aweshome/weather_station/README.md

# Weather station

## Internal unit (terminal)

### Heart:
	ATmega1284
	
### Peripherals:
	EG9018C - 640x480 8.4" mono lcd screen
	DS3231 - rtc
	BMP180 - pressure sensor
	nRF24L01 - wireless transceiver
	AM2302 - temperature and humidity sensor

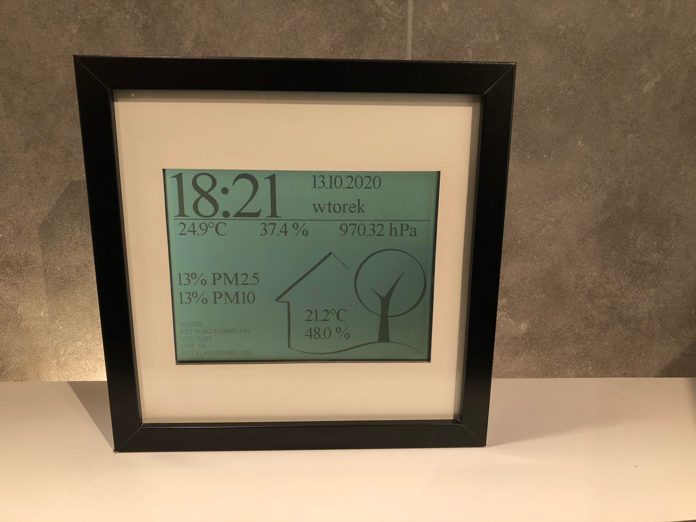
[picture p1: internal_terminal/images/internal_terminal_real_1.jpg]
internal real

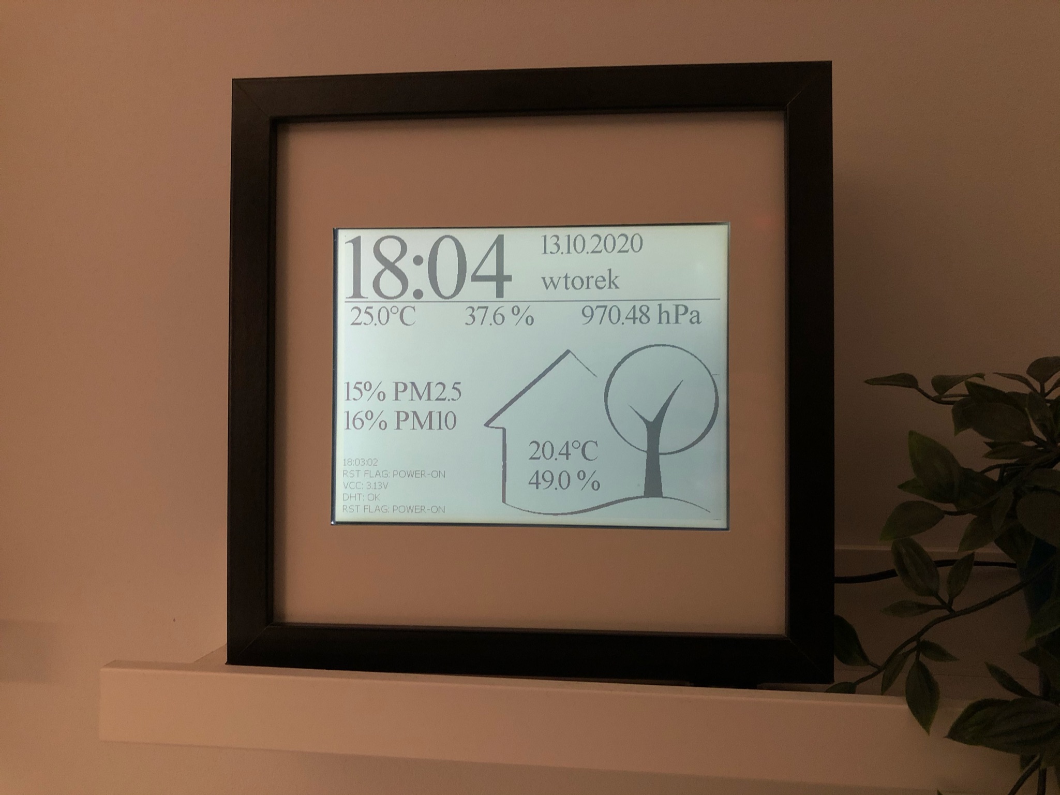
[picture p2: internal_terminal/images/internal_terminal_real_2.jpg]
internal real

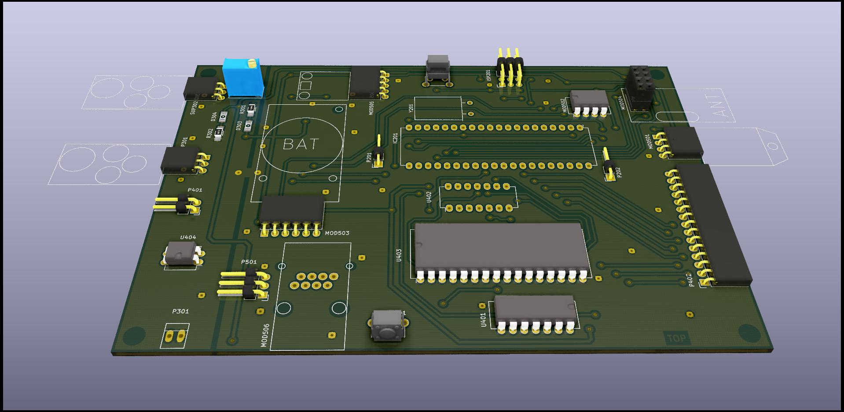
[picture p3: internal_terminal/images/internal_terminal_pcb_top.jpg]
internal pcb top

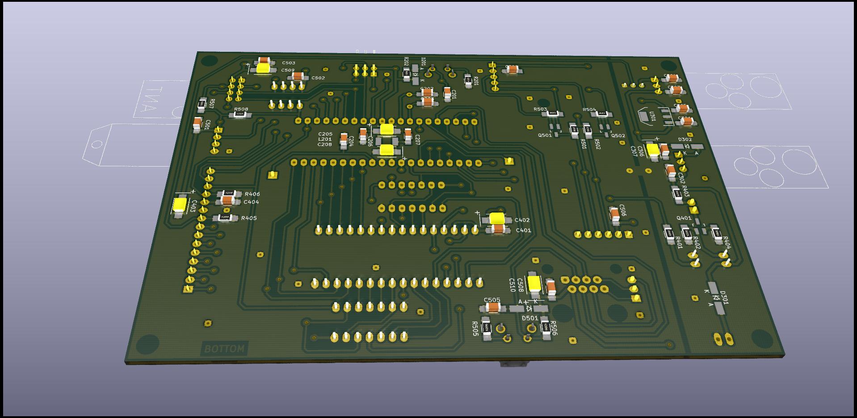
[picture p4: internal_terminal/images/internal_terminal_pcb_bottom.jpg]
internal pcb bottom


## External unit (sensor)

### Heart:
	ATxmega128A3U - uC
	
### Peripherals:
	PMSA003 - dust sensor
	nRF24L01
	AM2302	

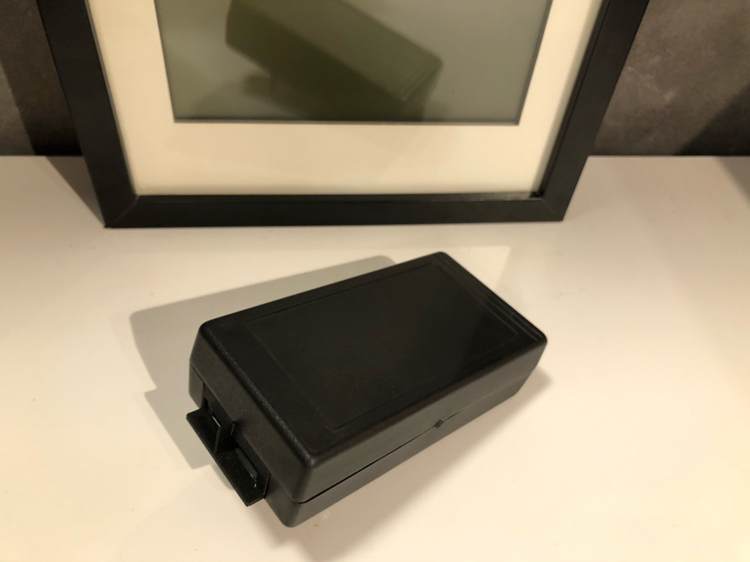
[picture p5: external_sensor/images/external_sensor_real_1.jpg]
external real

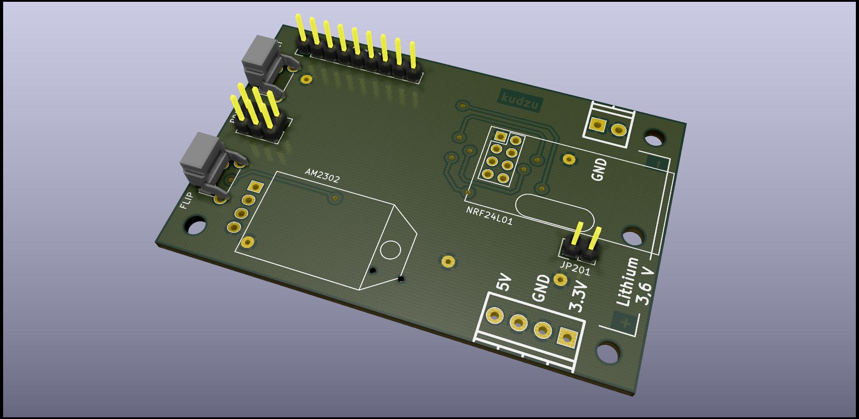
[picture p6: external_sensor/images/external_sensor_pcb_top.jpg]
external pcb top

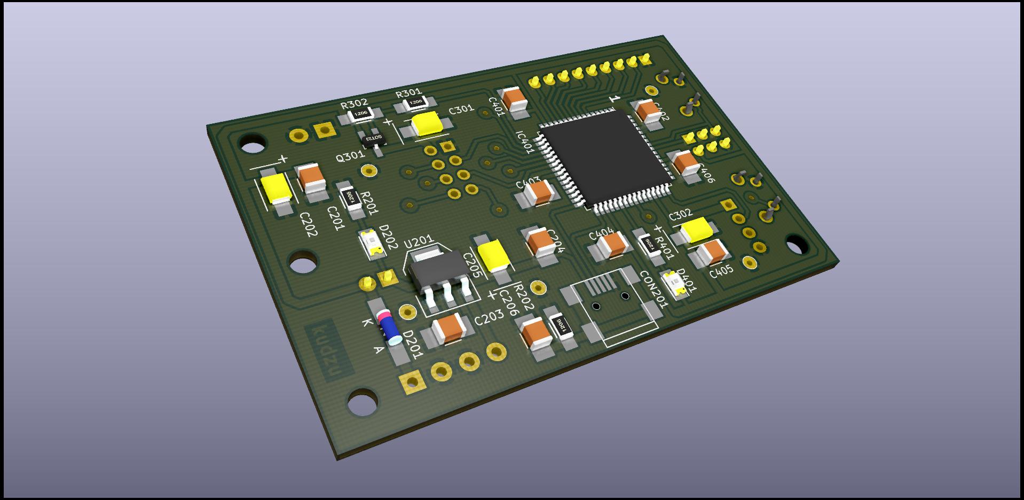
[picture p7: external_sensor/images/external_sensor_pcb_bottom.jpg]
external pcb bottom
