aweshome/weather_station/internal_terminal/hardware/solar_system_terminal_board.kicad_pcb

## KiCad design internal_terminal/hardware/solar_system_terminal_board.kicad_pcb (2020-10-13)

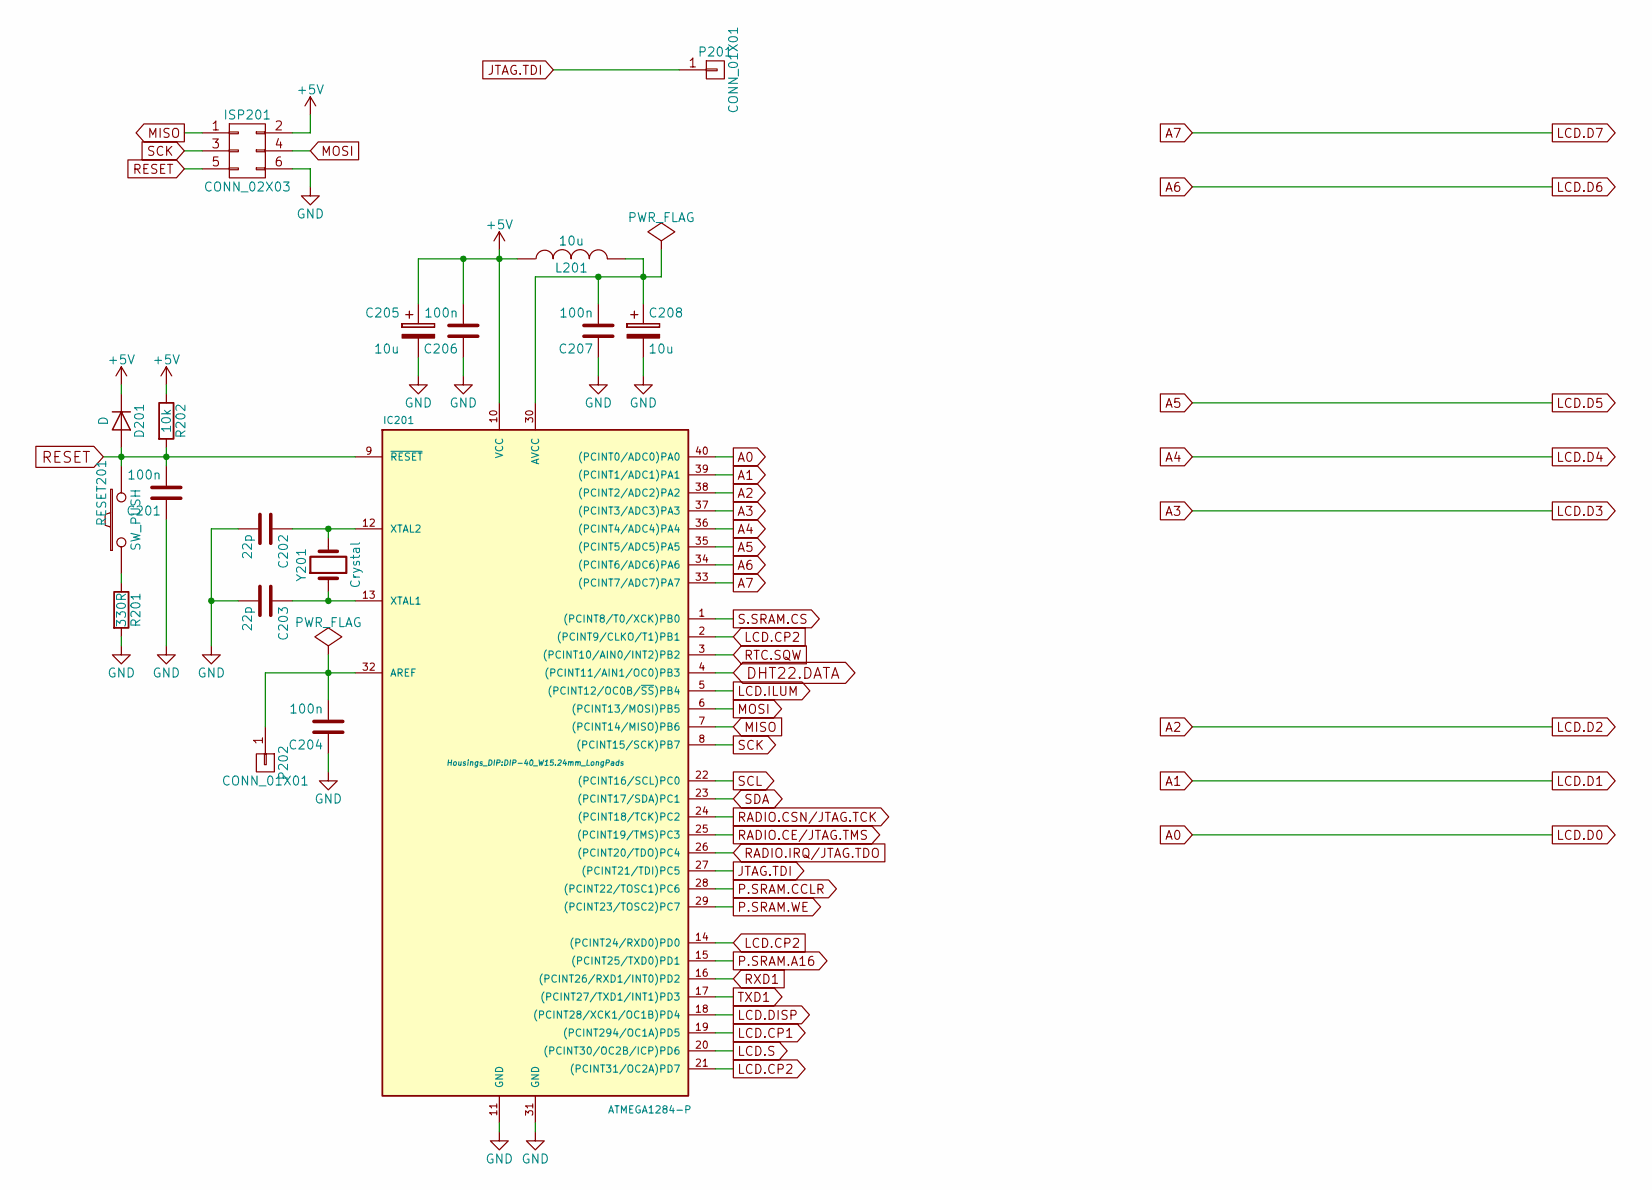
[picture p17: schematic main_unit.sch]

Parts:
C201, C204, C206, C207: 100n; C_1206_HandSoldering
C202, C203: 22p; C_1206_HandSoldering
C205, C208: 10u; TantalC_SizeB_EIA-3528_HandSoldering
D201: D; Diode-MiniMELF_Handsoldering
IC201: ATMEGA1284-P; DIP-40_W15.24mm_LongPads
ISP201: CONN_02X03; Pin_Header_Angled_2x03
L201: 10u; Neosid_Inductor_SM-NE45_SMD1812
P201, P202: CONN_01X01; Pin_Header_Straight_1x01
R201: 330R; R_1206_HandSoldering
R202: 10k; R_1206_HandSoldering
RESET201: SW_PUSH; SW_Tactile_SPST_Angled
Y201: Crystal; Crystal_HC49-U_Horizontal_Typ1

Connections:
+5V: C205.1, C206.2, D201.1 (K), IC201.10 (VCC), ISP201.2, L201.1, R202.1; also elsewhere on the board
A0: IC201.40 ((PCINT0/ADC0)PA0); also elsewhere on the board
A1: IC201.39 ((PCINT1/ADC1)PA1); also elsewhere on the board
A2: IC201.38 ((PCINT2/ADC2)PA2); also elsewhere on the board
A3: IC201.37 ((PCINT3/ADC3)PA3); also elsewhere on the board
A4: IC201.36 ((PCINT4/ADC4)PA4); also elsewhere on the board
A5: IC201.35 ((PCINT5/ADC5)PA5); also elsewhere on the board
A6: IC201.34 ((PCINT6/ADC6)PA6); also elsewhere on the board
A7: IC201.33 ((PCINT7/ADC7)PA7); also elsewhere on the board
DHT22.DATA: IC201.4 ((PCINT11/AIN1/OC0)PB3); also elsewhere on the board
GND: C201.1, C202.2, C203.2, C204.1, C205.2, C206.1, C207.1, C208.2, IC201.11 (GND), IC201.31 (GND), ISP201.6, R201.2; also elsewhere on the board
JTAG.TDI: IC201.27 ((PCINT21/TDI)PC5), P201.1
LCD.CP1: IC201.19 ((PCINT294/OC1A)PD5); also elsewhere on the board
LCD.CP2: IC201.2 ((PCINT9/CLKO/T1)PB1), IC201.14 ((PCINT24/RXD0)PD0), IC201.21 ((PCINT31/OC2A)PD7); also elsewhere on the board
LCD.DISP: IC201.18 ((PCINT28/XCK1/OC1B)PD4); also elsewhere on the board
LCD.ILUM: IC201.5 ((PCINT12/OC0B/~SS~)PB4); also elsewhere on the board
LCD.S: IC201.20 ((PCINT30/OC2B/ICP)PD6); also elsewhere on the board
MISO: IC201.7 ((PCINT14/MISO)PB6), ISP201.1; also elsewhere on the board
MOSI: IC201.6 ((PCINT13/MOSI)PB5), ISP201.4; also elsewhere on the board
unnamed: C202.1, IC201.12 (XTAL2), Y201.2
unnamed: C203.1, IC201.13 (XTAL1), Y201.1
unnamed: C204.2, IC201.32 (AREF), P202.1
unnamed: C207.2, C208.1, IC201.30 (AVCC), L201.2
unnamed: R201.1, RESET201.1
P.SRAM.A16: IC201.15 ((PCINT25/TXD0)PD1); also elsewhere on the board
P.SRAM.CCLR: IC201.28 ((PCINT22/TOSC1)PC6); also elsewhere on the board
P.SRAM.WE: IC201.29 ((PCINT23/TOSC2)PC7); also elsewhere on the board
RADIO.CE/JTAG.TMS: IC201.25 ((PCINT19/TMS)PC3); also elsewhere on the board
RADIO.CSN/JTAG.TCK: IC201.24 ((PCINT18/TCK)PC2); also elsewhere on the board
RADIO.IRQ/JTAG.TDO: IC201.26 ((PCINT20/TDO)PC4); also elsewhere on the board
RESET: C201.2, D201.2 (A), IC201.9 (~RESET), ISP201.5, R202.2, RESET201.2
RTC.SQW: IC201.3 ((PCINT10/AIN0/INT2)PB2); also elsewhere on the board
RXD1: IC201.16 ((PCINT26/RXD1/INT0)PD2); also elsewhere on the board
S.SRAM.CS: IC201.1 ((PCINT8/T0/XCK)PB0); also elsewhere on the board
SCK: IC201.8 ((PCINT15/SCK)PB7), ISP201.3; also elsewhere on the board
SCL: IC201.22 ((PCINT16/SCL)PC0); also elsewhere on the board
SDA: IC201.23 ((PCINT17/SDA)PC1); also elsewhere on the board
TXD1: IC201.17 ((PCINT27/TXD1/INT1)PD3); also elsewhere on the board

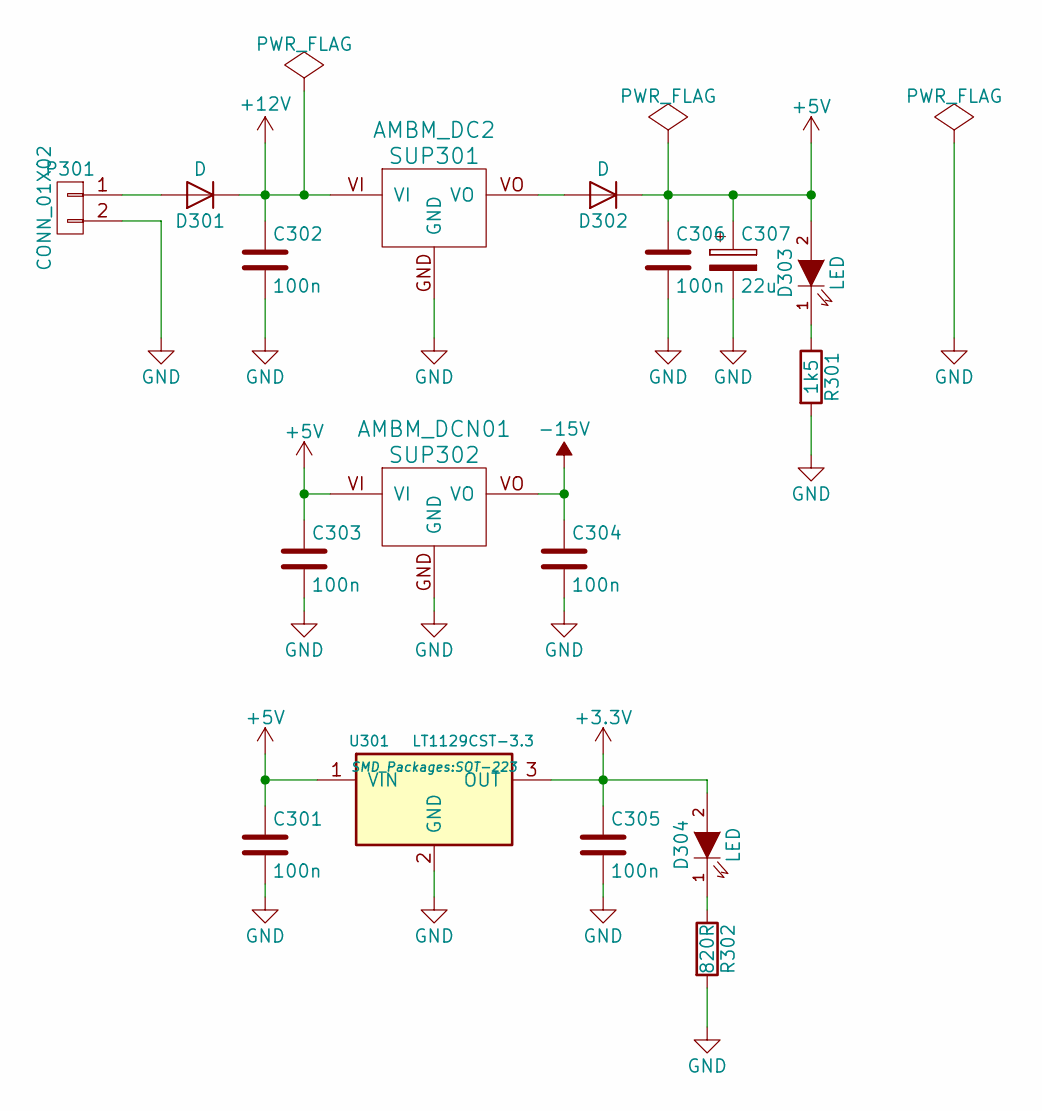
[picture p18: schematic supply.sch]

Parts:
C301, C302, C303, C304, C305, C306: 100n; C_1206_HandSoldering
C307: 22u; TantalC_SizeB_EIA-3528_HandSoldering
D301, D302: D; Diode-MiniMELF_Handsoldering
D303, D304: LED; LED-1206
P301: CONN_01X02; AK300-2
R301: 1k5; R_1206_HandSoldering
R302: 820R; R_1206_HandSoldering
SUP301: AMBM_DC2; DC2_Socket_H
SUP302: AMBM_DCN01; DC2_Socket_H
U301: LT1129CST-3.3; SOT-223

Connections:
+3V3: C305.1, D304.2 (A), U301.3 (OUT); also elsewhere on the board
+5V: C301.1, C303.1, C306.1, C307.1, D302.1 (K), D303.2 (A), SUP302.VI, U301.1 (VIN); also elsewhere on the board
+12V: C302.1, D301.1 (K), SUP301.VI; also elsewhere on the board
-15V: C304.1, SUP302.VO; also elsewhere on the board
GND: C301.2, C302.2, C303.2, C304.2, C305.2, C306.2, C307.2, P301.2, R301.2, R302.2, SUP301.GND, SUP302.GND, U301.2 (GND); also elsewhere on the board
unnamed: D301.2 (A), P301.1
unnamed: D302.2 (A), SUP301.VO
unnamed: D303.1 (K), R301.1
unnamed: D304.1 (K), R302.1

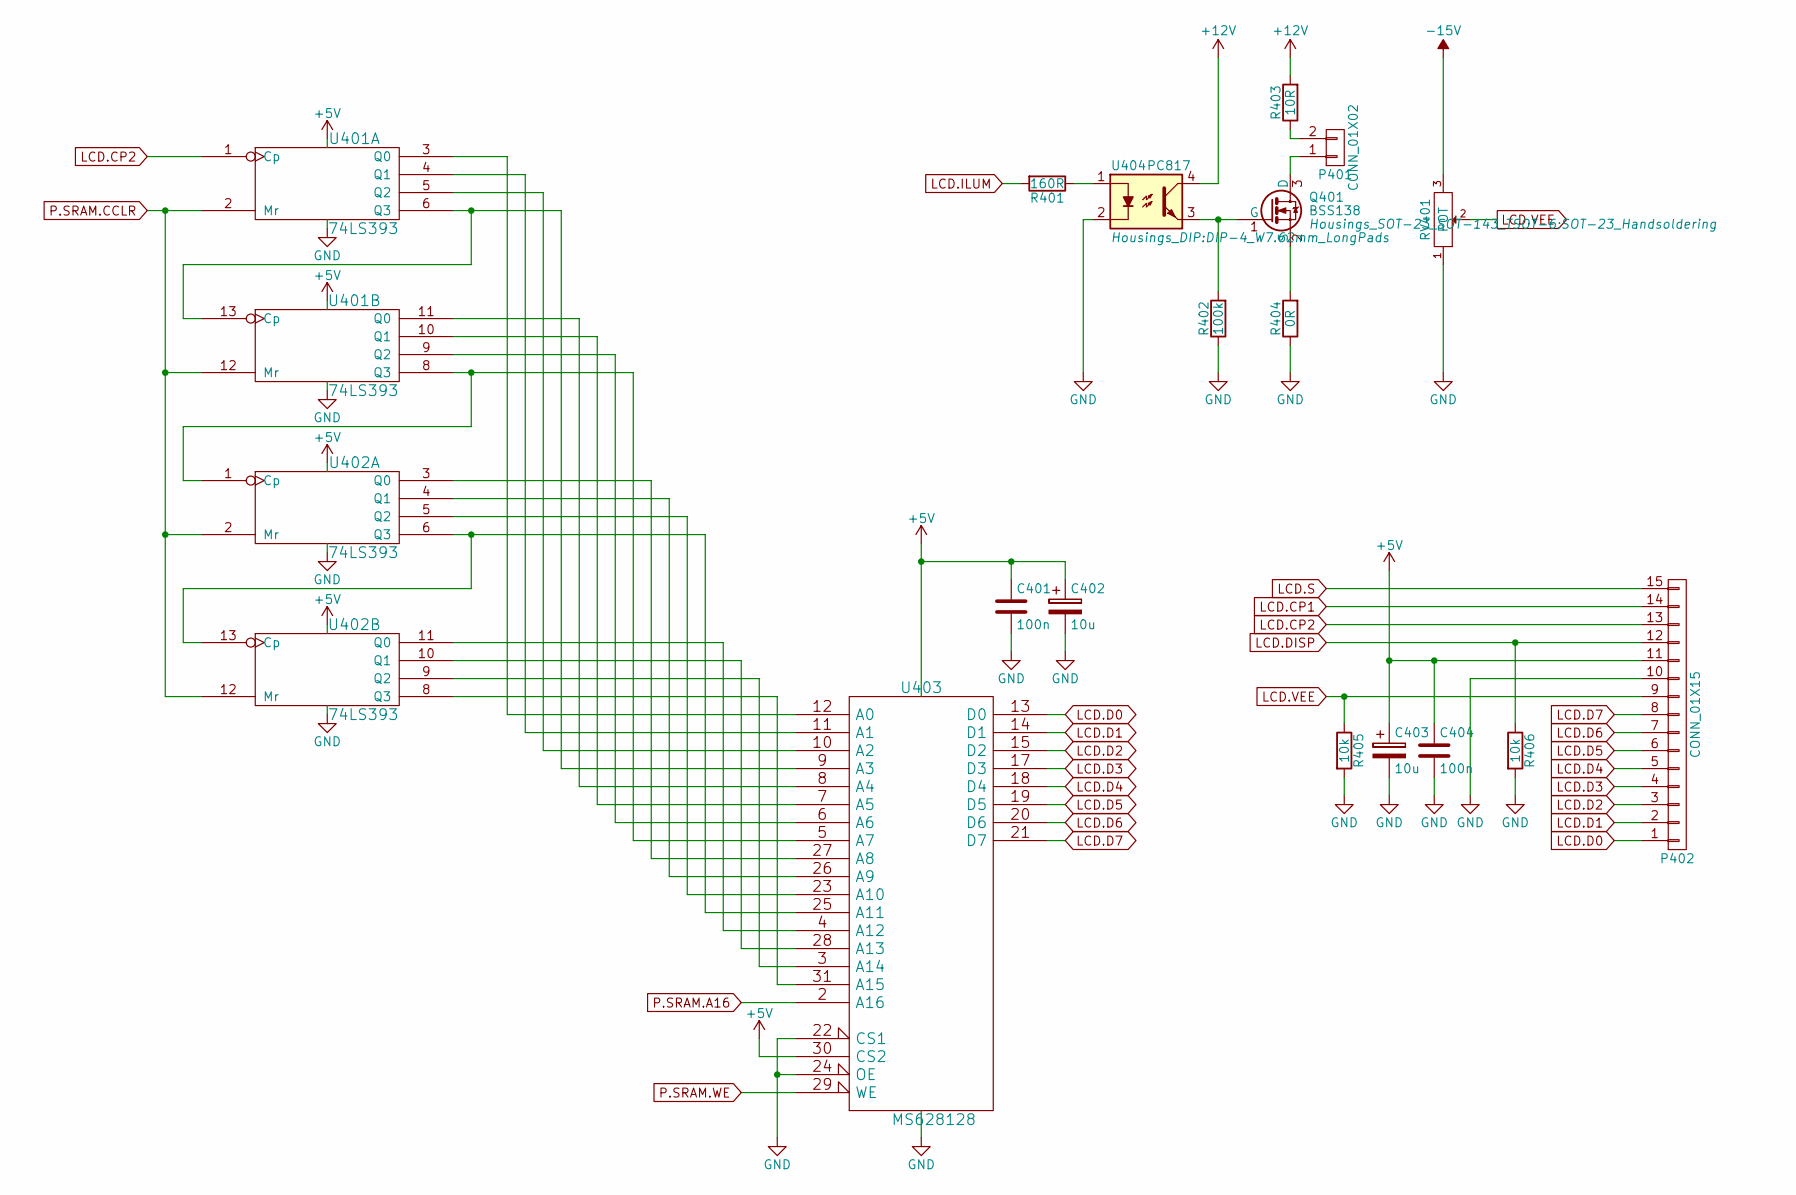
[picture p19: schematic lcd.sch]

Parts:
C401, C404: 100n; C_1206_HandSoldering
C402, C403: 10u; TantalC_SizeB_EIA-3528_HandSoldering
P401: CONN_01X02; Pin_Header_Angled_1x02
P402: CONN_01X15; Socket_Strip_Straight_1x15
Q401: BSS138; SOT-23_Handsoldering
R401: 160R; R_1206_HandSoldering
R402: 100k; R_1206_HandSoldering
R403: 10R; R_1206_HandSoldering
R404: 0R; R_1206_HandSoldering
R405, R406: 10k; R_1206_HandSoldering
RV401: POT; Potentiometer_Bourns_3296W_3-8Zoll_Inline_ScrewUp
U401, U402: 74LS393; DIP-14_W7.62mm_LongPads
U403: MS628128; DIP-32_W15.24mm_LongPads
U404: PC817; DIP-4_W7.62mm_LongPads

Connections:
+5V: C401.1, C402.1, C403.1, C404.1, P402.11, U401.14 (VCC), U402.14 (VCC), U403.30 (CS2), U403.32 (VCC); also elsewhere on the board
+12V: R403.2, U404.4; also elsewhere on the board
-15V: RV401.3; also elsewhere on the board
A0: P402.1, U403.13 (D0); also elsewhere on the board
A1: P402.2, U403.14 (D1); also elsewhere on the board
A2: P402.3, U403.15 (D2); also elsewhere on the board
A3: P402.4, U403.17 (D3); also elsewhere on the board
A4: P402.5, U403.18 (D4); also elsewhere on the board
A5: P402.6, U403.19 (D5); also elsewhere on the board
A6: P402.7, U403.20 (D6); also elsewhere on the board
A7: P402.8, U403.21 (D7); also elsewhere on the board
GND: C401.2, C402.2, C403.2, C404.2, P402.10, R402.1, R404.1, R405.2, R406.2, RV401.1, U401.7 (GND), U402.7 (GND), U403.16 (GND), U403.22 (CS1), U403.24 (OE), U404.2; also elsewhere on the board
LCD.CP1: P402.14; also elsewhere on the board
LCD.CP2: P402.13, U401.1 (Cp); also elsewhere on the board
LCD.DISP: P402.12, R406.1; also elsewhere on the board
LCD.ILUM: R401.2; also elsewhere on the board
LCD.S: P402.15; also elsewhere on the board
LCD.VEE: P402.9, R405.1, RV401.2
unnamed: P401.1, Q401.3 (D)
unnamed: P401.2, R403.1
unnamed: Q401.1 (G), R402.2, U404.3
unnamed: Q401.2 (S), R404.2
unnamed: R401.1, U404.1
unnamed: U401.3 (Q0), U403.12 (A0)
unnamed: U401.4 (Q1), U403.11 (A1)
unnamed: U401.5 (Q2), U403.10 (A2)
unnamed: U401.8 (Q3), U402.1 (Cp), U403.5 (A7)
unnamed: U401.9 (Q2), U403.6 (A6)
unnamed: U401.10 (Q1), U403.7 (A5)
unnamed: U401.11 (Q0), U403.8 (A4)
unnamed: U401.6 (Q3), U401.13 (Cp), U403.9 (A3)
unnamed: U402.3 (Q0), U403.27 (A8)
unnamed: U402.4 (Q1), U403.26 (A9)
unnamed: U402.5 (Q2), U403.23 (A10)
unnamed: U402.8 (Q3), U403.31 (A15)
unnamed: U402.9 (Q2), U403.3 (A14)
unnamed: U402.10 (Q1), U403.28 (A13)
unnamed: U402.11 (Q0), U403.4 (A12)
unnamed: U402.6 (Q3), U402.13 (Cp), U403.25 (A11)
P.SRAM.A16: U403.2 (A16); also elsewhere on the board
P.SRAM.CCLR: U401.2 (Mr), U401.12 (Mr), U402.2 (Mr), U402.12 (Mr); also elsewhere on the board
P.SRAM.WE: U403.29 (WE); also elsewhere on the board

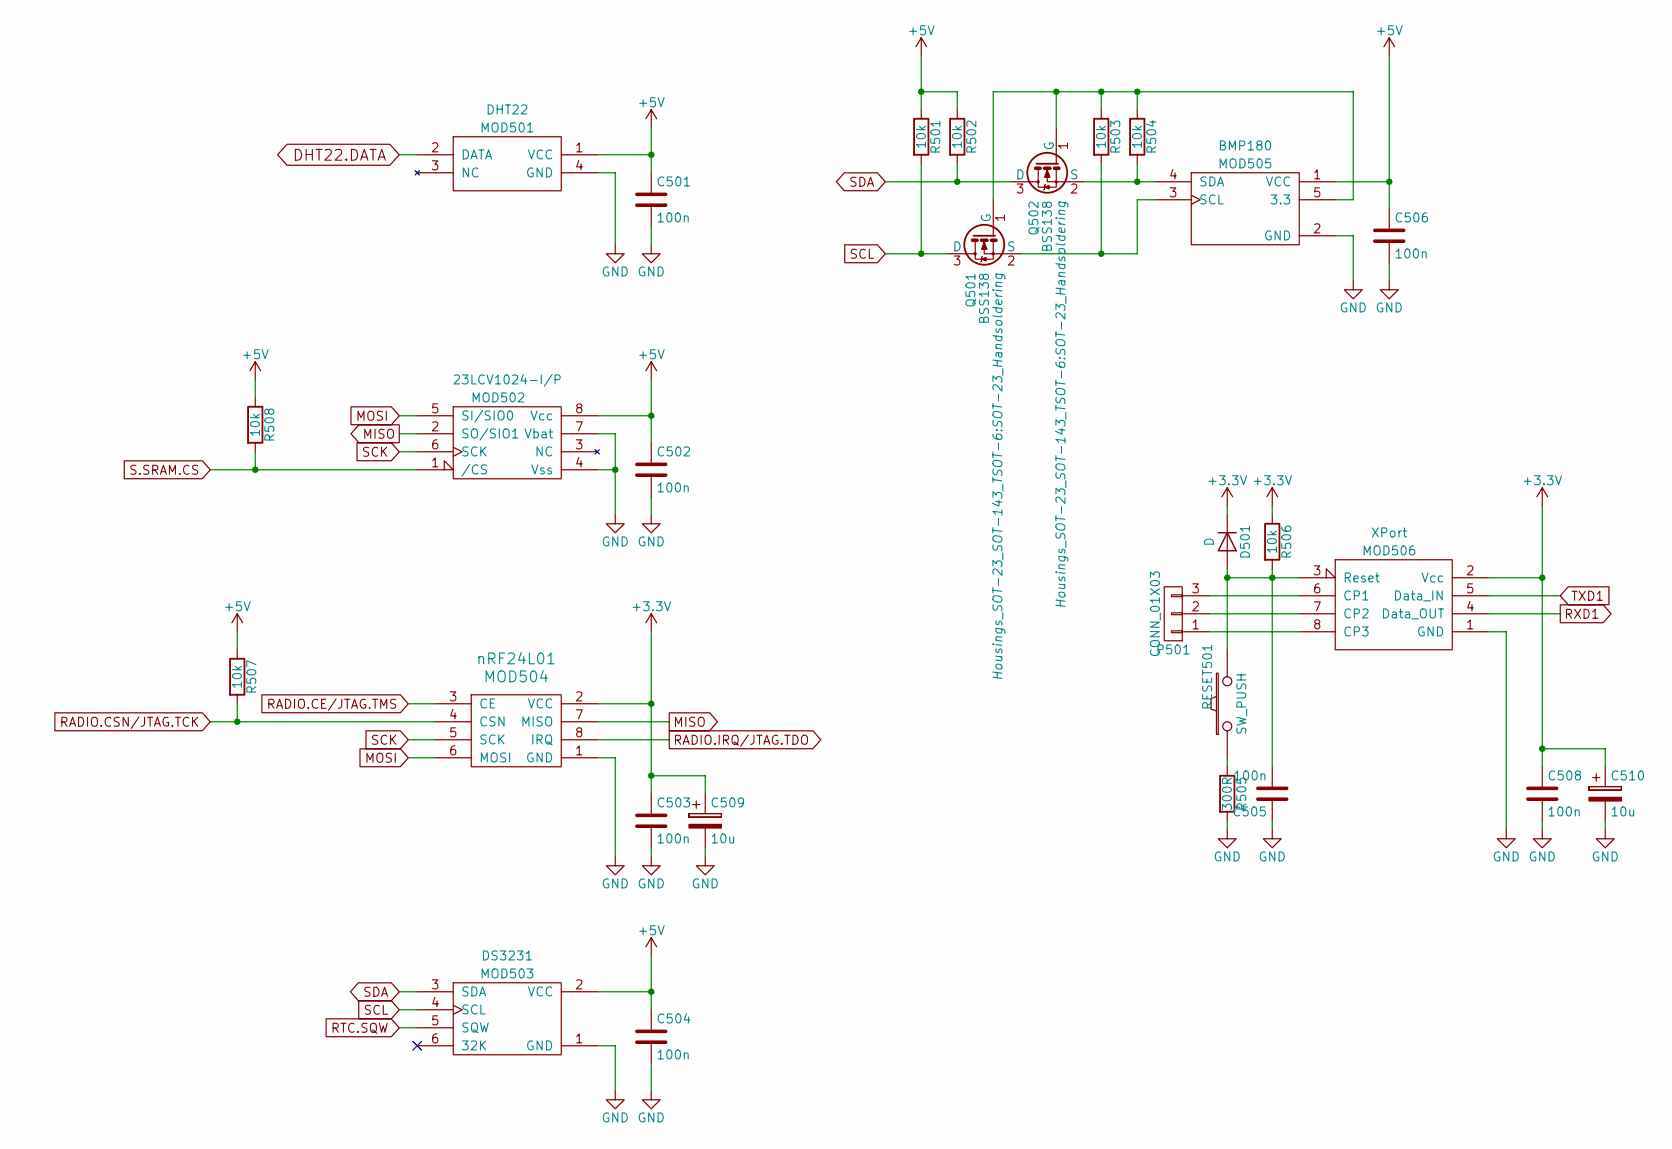
[picture p20: schematic periphery.sch]

Parts:
C501, C502, C503, C504, C505, C506, C508: 100n; C_1206_HandSoldering
C509, C510: 10u; TantalC_SizeB_EIA-3528_HandSoldering
D501: D; Diode-MiniMELF_Handsoldering
MOD501: DHT22; AM2302_Socket_H
MOD502: 23LCV1024-I/P; DIP-8_W7.62mm_LongPads
MOD503: DS3231; DS3231_Socket_H
MOD504: nRF24L01
MOD505: BMP180; BMP180_Socket_H
MOD506: XPort
P501: CONN_01X03; Pin_Header_Straight_1x03
Q501, Q502: BSS138; SOT-23_Handsoldering
R501, R502, R503, R504, R506, R507, R508: 10k; R_1206_HandSoldering
R505: 300R; R_1206_HandSoldering
RESET501: SW_PUSH; SW_Tactile_SPST_Angled

Connections:
+3V3: C503.1, C508.1, C509.1, C510.1, D501.1 (K), MOD504.2 (VCC), MOD506.2 (Vcc), R506.1; also elsewhere on the board
+5V: C501.1, C502.1, C504.1, C506.1, MOD501.1 (VCC), MOD502.8 (Vcc), MOD503.2 (VCC), MOD505.1 (VCC), R501.1, R502.1, R507.1, R508.1; also elsewhere on the board
DHT22.DATA: MOD501.2 (DATA); also elsewhere on the board
GND: C501.2, C502.2, C503.2, C504.2, C505.1, C506.2, C508.2, C509.2, C510.2, MOD501.4 (GND), MOD502.4 (Vss), MOD502.7 (Vbat), MOD503.1 (GND), MOD504.1 (GND), MOD505.2 (GND), MOD506.1 (GND), R505.2; also elsewhere on the board
MISO: MOD502.2 (SO/SIO1), MOD504.7 (MISO); also elsewhere on the board
MOSI: MOD502.5 (SI/SIO0), MOD504.6 (MOSI); also elsewhere on the board
unnamed: C505.2, D501.2 (A), MOD506.3 (Reset), R506.2, RESET501.2
unnamed: MOD505.3 (SCL), Q501.2 (S), R503.2
unnamed: MOD505.4 (SDA), Q502.2 (S), R504.2
unnamed: MOD505.5 (3.3), Q501.1 (G), Q502.1 (G), R503.1, R504.1
unnamed: MOD506.6 (CP1), P501.3
unnamed: MOD506.7 (CP2), P501.2
unnamed: MOD506.8 (CP3), P501.1
unnamed: R505.1, RESET501.1
RADIO.CE/JTAG.TMS: MOD504.3 (CE); also elsewhere on the board
RADIO.CSN/JTAG.TCK: MOD504.4 (CSN), R507.2; also elsewhere on the board
RADIO.IRQ/JTAG.TDO: MOD504.8 (IRQ); also elsewhere on the board
RTC.SQW: MOD503.5 (SQW); also elsewhere on the board
RXD1: MOD506.4 (Data_OUT); also elsewhere on the board
S.SRAM.CS: MOD502.1 (/CS), R508.2; also elsewhere on the board
SCK: MOD502.6 (SCK), MOD504.5 (SCK); also elsewhere on the board
SCL: MOD503.4 (SCL), Q501.3 (D), R501.2; also elsewhere on the board
SDA: MOD503.3 (SDA), Q502.3 (D), R502.2; also elsewhere on the board
TXD1: MOD506.5 (Data_IN); also elsewhere on the board

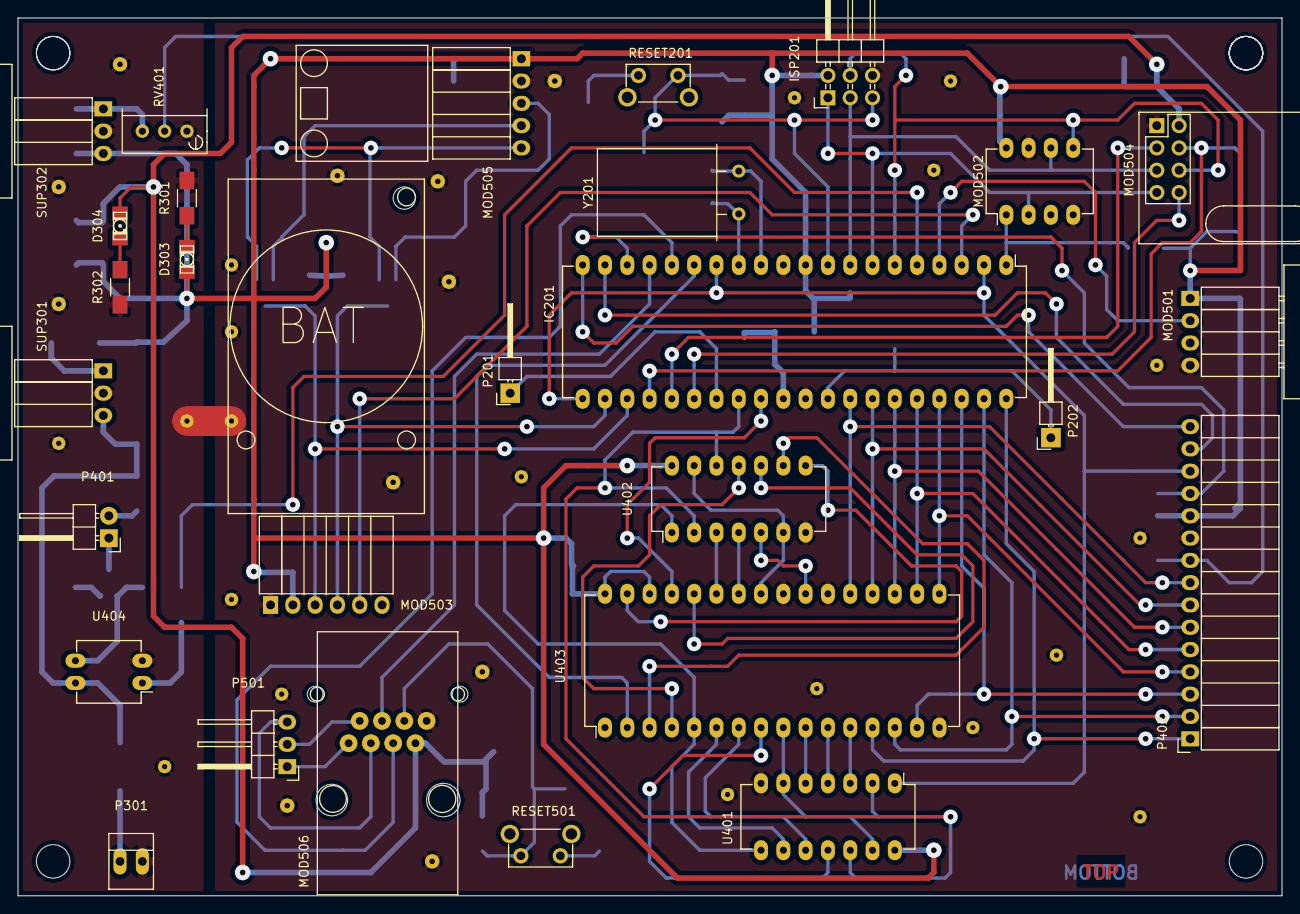
[picture p21: board solar_system_terminal_board.kicad_pcb from above]

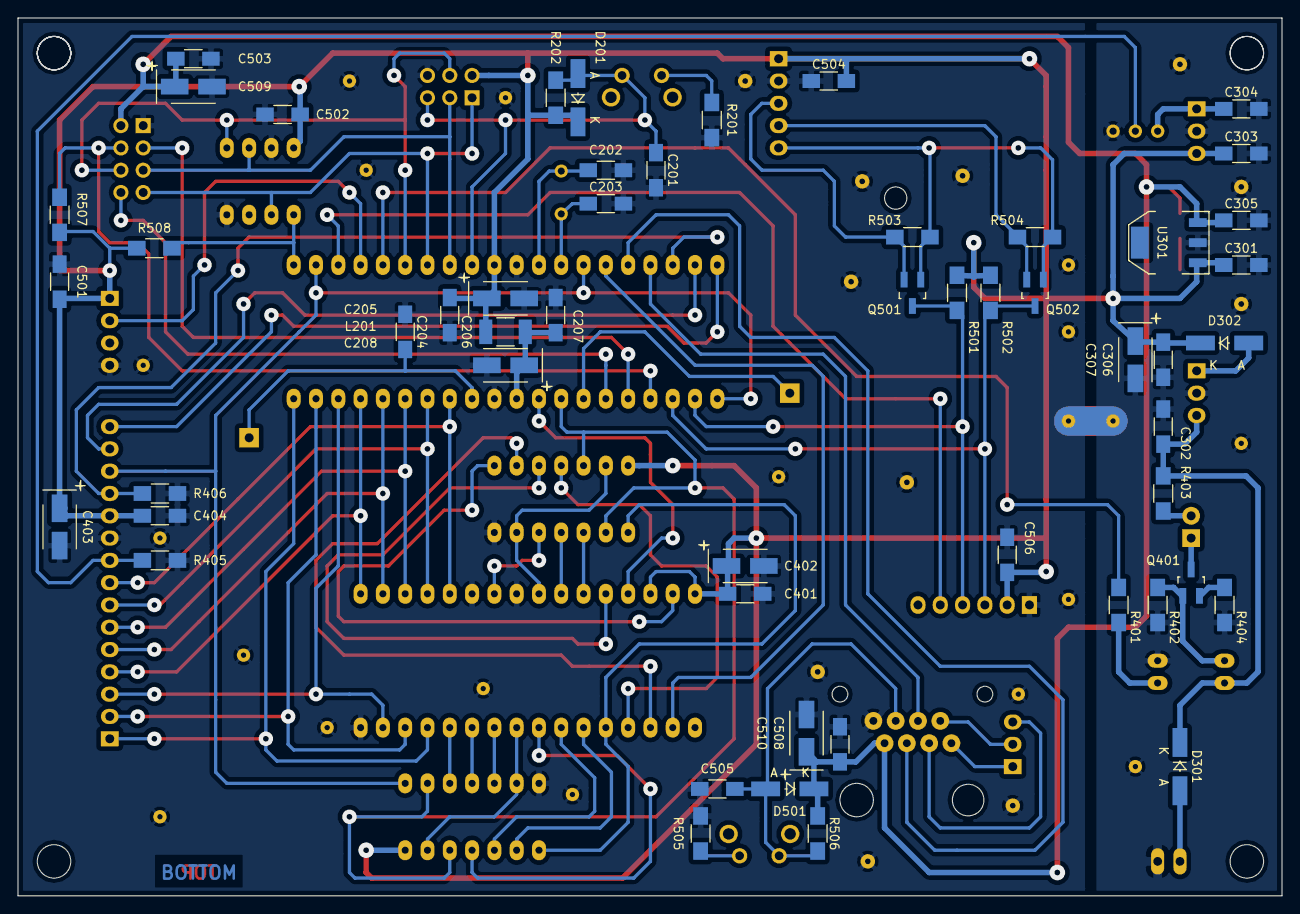
[picture p22: board solar_system_terminal_board.kicad_pcb from below]

Board: 2 copper layers, 144.0 x 100.0 mm, 81 parts (53 on the bottom side), 75 nets.
