aweshome/weather_station/external_sensor/hardware/solar_system_external_unit_board_2.kicad_pcb

## KiCad design external_sensor/hardware/solar_system_external_unit_board_2.kicad_pcb (2020-10-13)

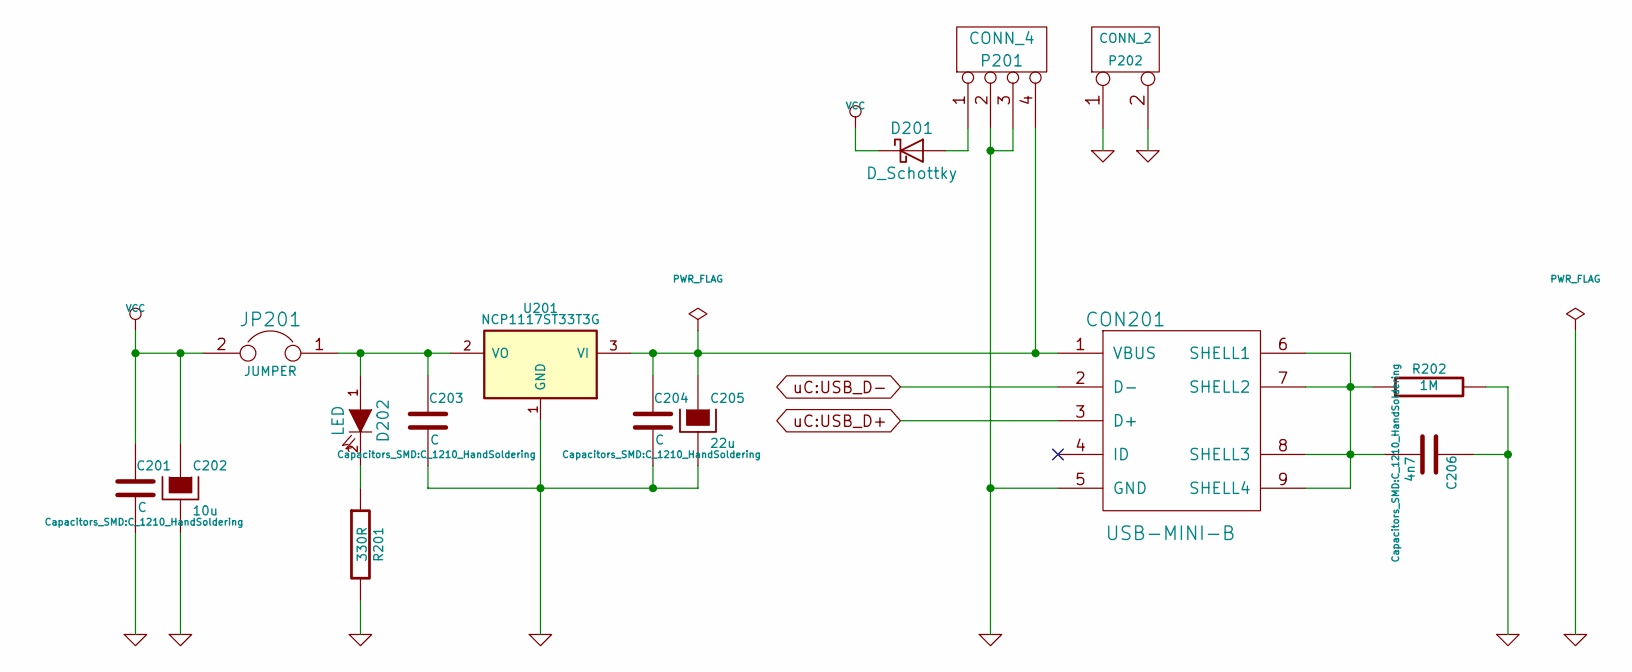
[picture p23: schematic supply.sch]

Parts:
C201, C203, C204: C; C_1210_HandSoldering
C202: 10u; TantalC_SizeB_EIA-3528_HandSoldering
C205: 22u; TantalC_SizeB_EIA-3528_HandSoldering
C206: 4n7; C_1210_HandSoldering
CON201: USB-MINI-B; USB_Mini-B_mod
D201: D_Schottky; MiniMELF_Handsoldering
D202: LED; LED_1206
JP201: JUMPER; Pin_Header_Straight_1x02
P201: CONN_4; pt_1,5-4-3,5-h
P202: CONN_2; pt_1,5-2-3,5-h
R201: 330R; R_1206_HandSoldering
R202: 1M; R_1206_HandSoldering
U201: NCP1117ST33T3G; SOT-223

Connections:
GND: C201.2, C202.2, C203.2, C204.2, C205.2, C206.1, CON201.5 (GND), P201.2, P201.3, P202.1, P202.2 (PM), R201.2, R202.2, U201.1 (GND); also elsewhere on the board
unnamed: C203.1, D202.1 (A), JP201.1, U201.2 (VO)
unnamed: C204.1, C205.1, CON201.1 (VBUS), P201.4, U201.3 (VI)
unnamed: C206.2, CON201.6 (SHELL1), CON201.7 (SHELL2), CON201.8 (SHELL3), CON201.9 (SHELL4), R202.1
unnamed: D201.2 (A), P201.1
unnamed: D202.2 (K), R201.1
VCC: C201.1, C202.1, D201.1 (K), JP201.2; also elsewhere on the board
uC:USB_D+: CON201.3 (D+); also elsewhere on the board
uC:USB_D-: CON201.2 (D-); also elsewhere on the board

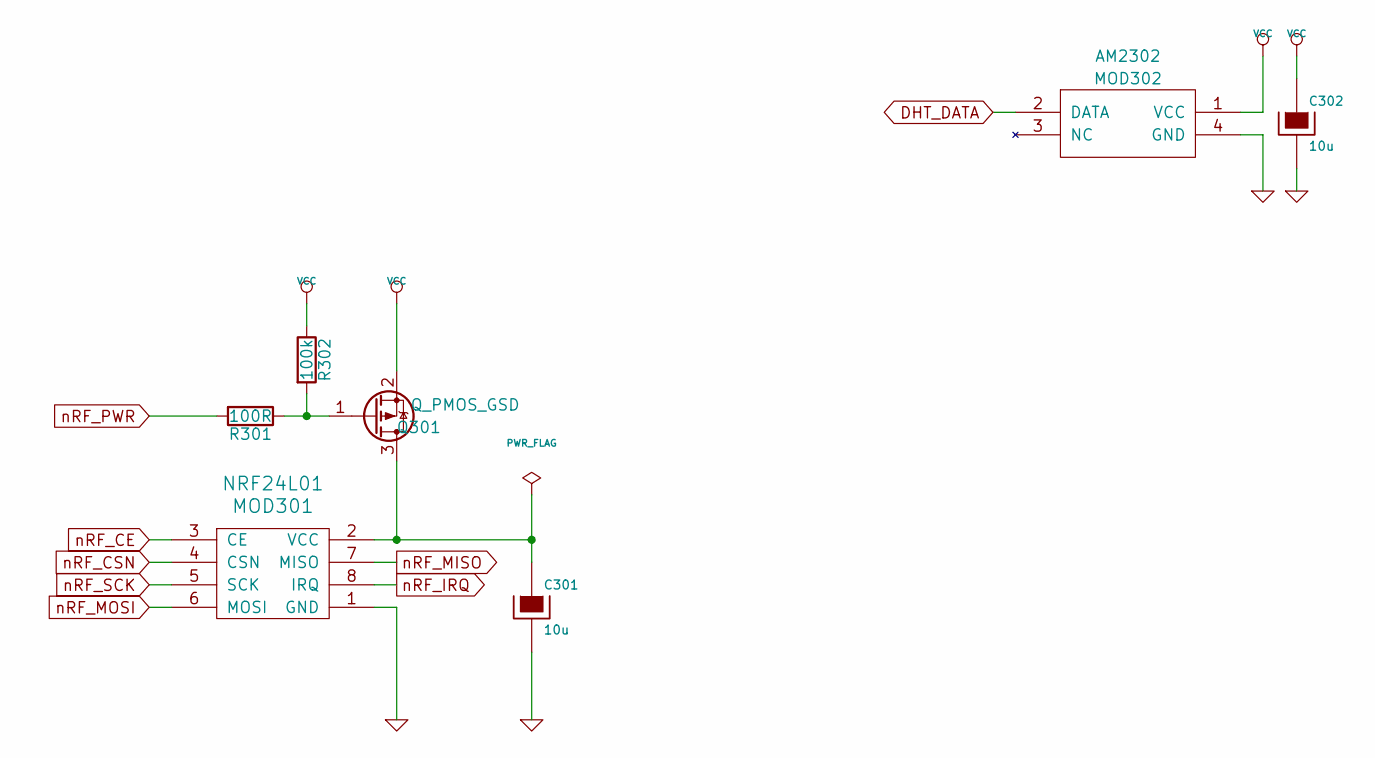
[picture p24: schematic periphery.sch]

Parts:
C301, C302: 10u; TantalC_SizeB_EIA-3528_HandSoldering
MOD301: NRF24L01; nRF24L01
MOD302: AM2302; AM2302_Naked_H
Q301: Q_PMOS_GSD; SOT-23_Handsoldering
R301: 100R; R_1206_HandSoldering
R302: 100k; R_1206_HandSoldering

Connections:
DHT_DATA: MOD302.2 (DATA); also elsewhere on the board
GND: C301.2, C302.2, MOD301.1 (GND), MOD302.4 (GND); also elsewhere on the board
unnamed: C301.1, MOD301.2 (VCC), Q301.3 (D)
unnamed: Q301.1 (G), R301.1, R302.2
VCC: C302.1, MOD302.1 (VCC), Q301.2 (S), R302.1; also elsewhere on the board
nRF_CE: MOD301.3 (CE); also elsewhere on the board
nRF_CSN: MOD301.4 (CSN); also elsewhere on the board
nRF_IRQ: MOD301.8 (IRQ); also elsewhere on the board
nRF_MISO: MOD301.7 (MISO); also elsewhere on the board
nRF_MOSI: MOD301.6 (MOSI); also elsewhere on the board
nRF_PWR: R301.2; also elsewhere on the board
nRF_SCK: MOD301.5 (SCK); also elsewhere on the board

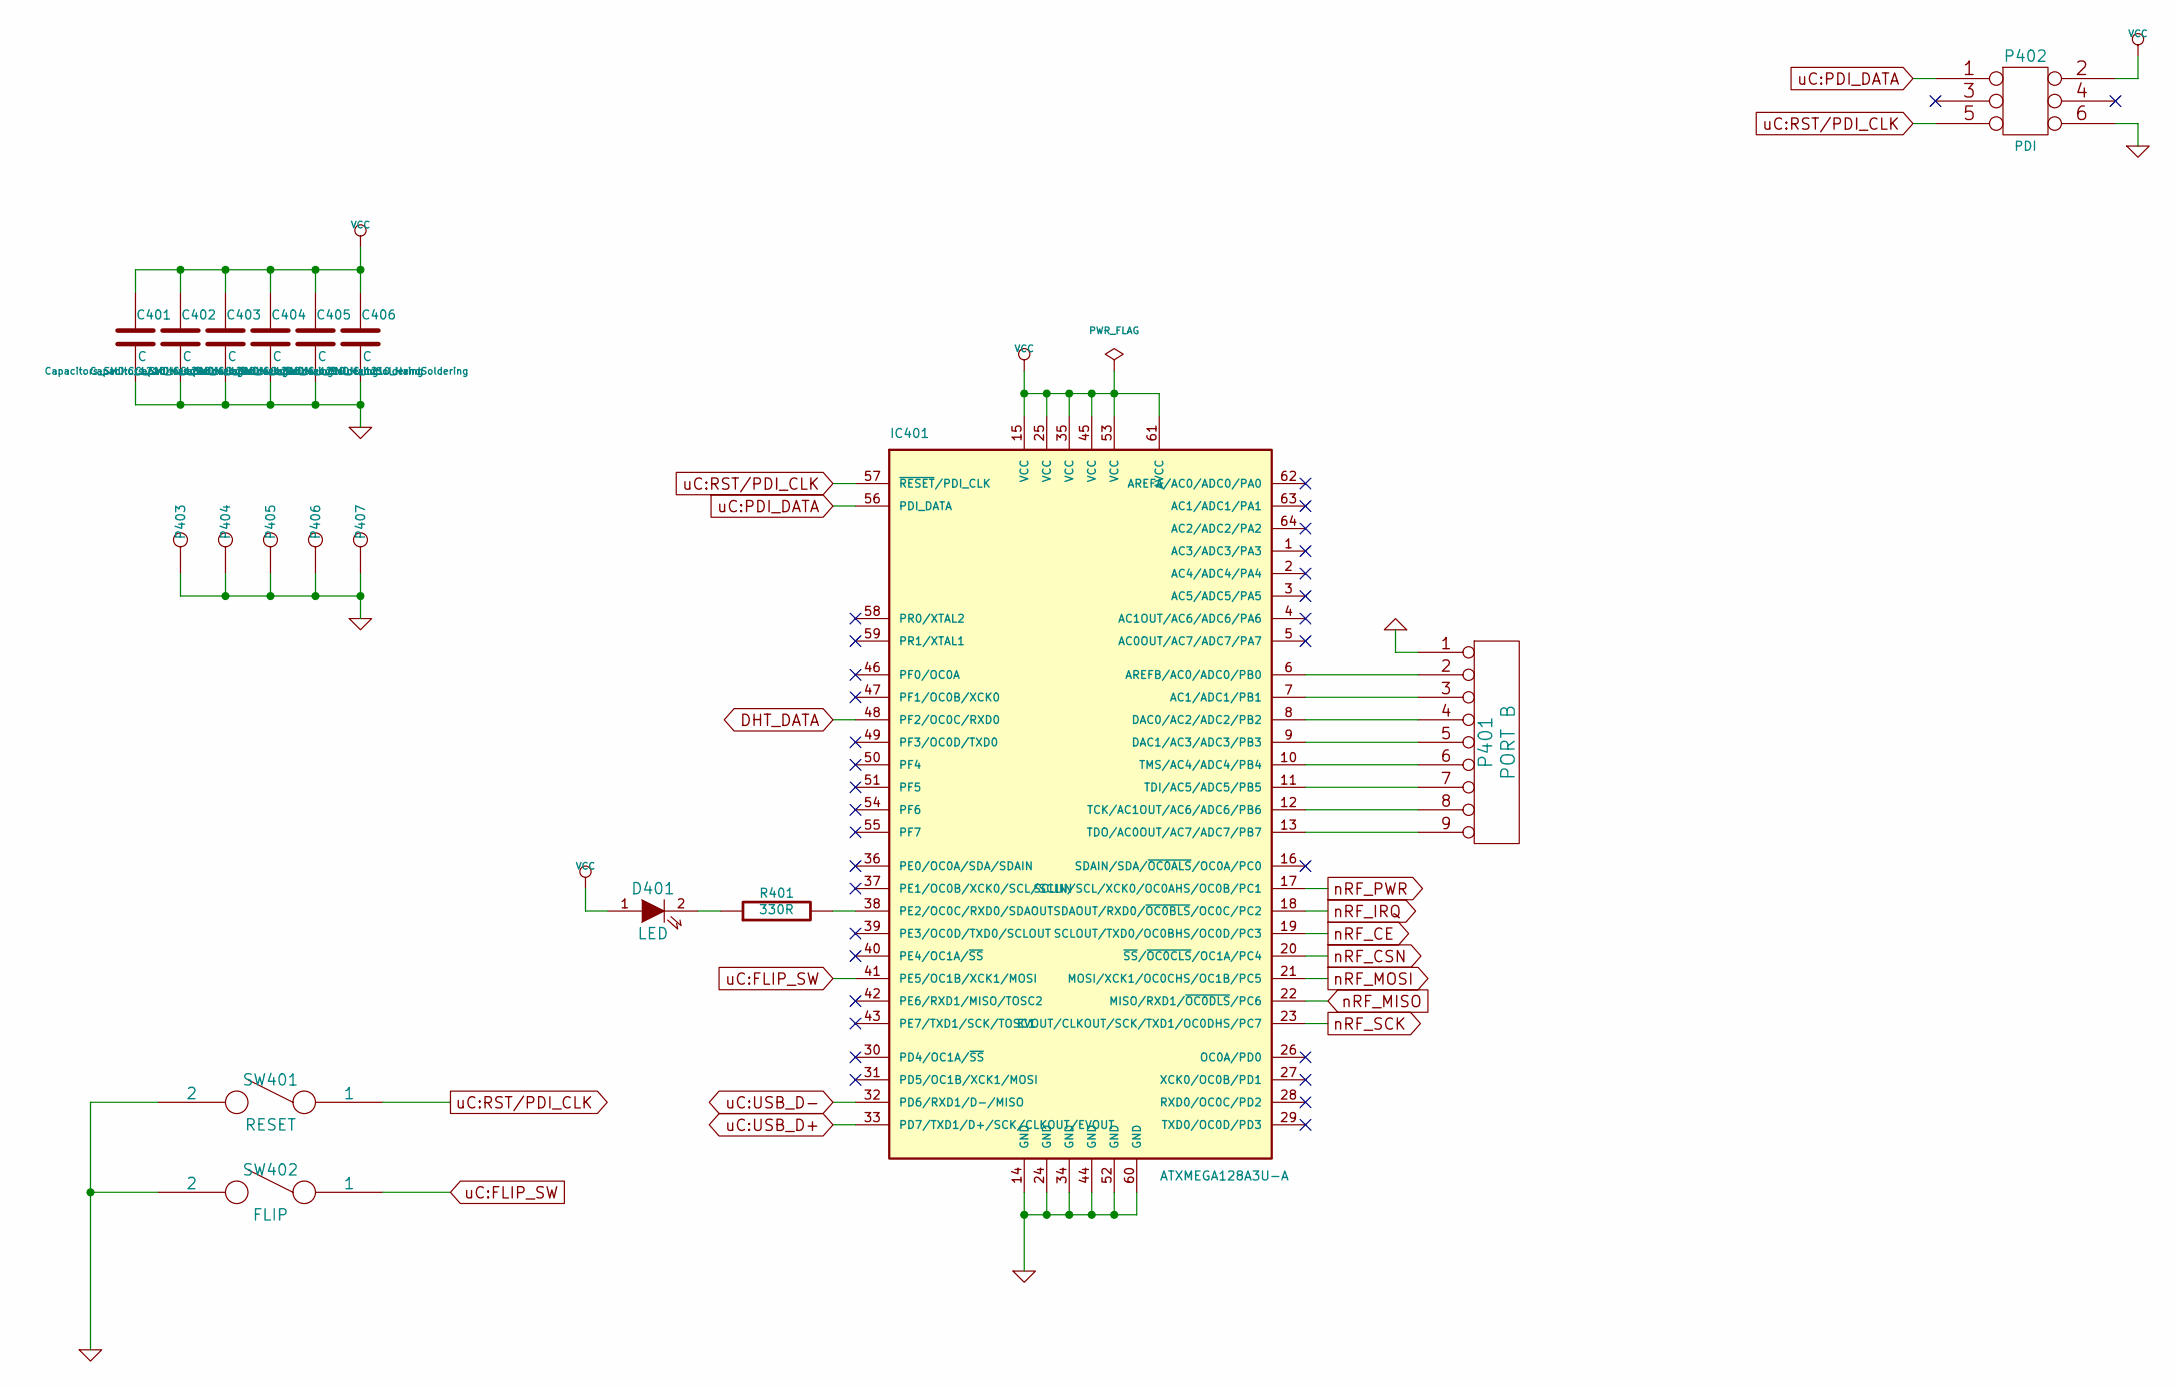
[picture p25: schematic uc.sch]

Parts:
C401, C402, C403, C404, C405, C406: C; C_1210_HandSoldering
D401: LED; LED_1206
IC401: ATXMEGA128A3U-A; TQFP-64_14x14mm_Pitch0.8mm
P401: PORT B; Pin_Header_Straight_1x09
P402: PDI; Pin_Header_Straight_2x03
P403, P404, P405, P406, P407: CONN_1; SolderWirePad_single_0-8mmDrill
R401: 330R; R_1206_HandSoldering
SW401: RESET; SW_Tactile_SPST_Angled
SW402: FLIP; SW_Tactile_SPST_Angled

Connections:
DHT_DATA: IC401.48 (PF2/OC0C/RXD0); also elsewhere on the board
GND: C401.2, C402.2, C403.2, C404.2, C405.2, C406.2, IC401.14 (GND), IC401.24 (GND), IC401.34 (GND), IC401.44 (GND), IC401.52 (GND), IC401.60 (GND), P401.1, P402.6, P403.1, P404.1, P405.1, P406.1, P407.1, SW401.2, SW402.2; also elsewhere on the board
unnamed: D401.2 (K), R401.1
unnamed: IC401.6 (AREFB/AC0/ADC0/PB0), P401.2
unnamed: IC401.7 (AC1/ADC1/PB1), P401.3
unnamed: IC401.8 (DAC0/AC2/ADC2/PB2), P401.4
unnamed: IC401.9 (DAC1/AC3/ADC3/PB3), P401.5
unnamed: IC401.10 (TMS/AC4/ADC4/PB4), P401.6
unnamed: IC401.11 (TDI/AC5/ADC5/PB5), P401.7
unnamed: IC401.12 (TCK/AC1OUT/AC6/ADC6/PB6), P401.8
unnamed: IC401.13 (TDO/AC0OUT/AC7/ADC7/PB7), P401.9
unnamed: IC401.38 (PE2/OC0C/RXD0/SDAOUT), R401.2
VCC: C401.1, C402.1, C403.1, C404.1, C405.1, C406.1, D401.1 (A), IC401.15 (VCC), IC401.25 (VCC), IC401.35 (VCC), IC401.45 (VCC), IC401.53 (VCC), IC401.61 (AVCC), P402.2; also elsewhere on the board
nRF_CE: IC401.19 (SCLOUT/TXD0/OC0BHS/OC0D/PC3); also elsewhere on the board
nRF_CSN: IC401.20 (~SS~/~OC0CLS~/OC1A/PC4); also elsewhere on the board
nRF_IRQ: IC401.18 (SDAOUT/RXD0/~OC0BLS~/OC0C/PC2); also elsewhere on the board
nRF_MISO: IC401.22 (MISO/RXD1/~OC0DLS~/PC6); also elsewhere on the board
nRF_MOSI: IC401.21 (MOSI/XCK1/OC0CHS/OC1B/PC5); also elsewhere on the board
nRF_PWR: IC401.17 (SCLIN/SCL/XCK0/OC0AHS/OC0B/PC1); also elsewhere on the board
nRF_SCK: IC401.23 (EVOUT/CLKOUT/SCK/TXD1/OC0DHS/PC7); also elsewhere on the board
uC:FLIP_SW: IC401.41 (PE5/OC1B/XCK1/MOSI), SW402.1
uC:PDI_DATA: IC401.56 (PDI_DATA), P402.1
uC:RST/PDI_CLK: IC401.57 (~RESET~/PDI_CLK), P402.5, SW401.1
uC:USB_D+: IC401.33 (PD7/TXD1/D+/SCK/CLKOUT/EVOUT); also elsewhere on the board
uC:USB_D-: IC401.32 (PD6/RXD1/D-/MISO); also elsewhere on the board
