aweshome/weather_station/external_sensor/hardware/solar_system_external_unit_board_2.kicad_pcb

## KiCad design external_sensor/hardware/solar_system_external_unit_board_2.kicad_pcb (continued)

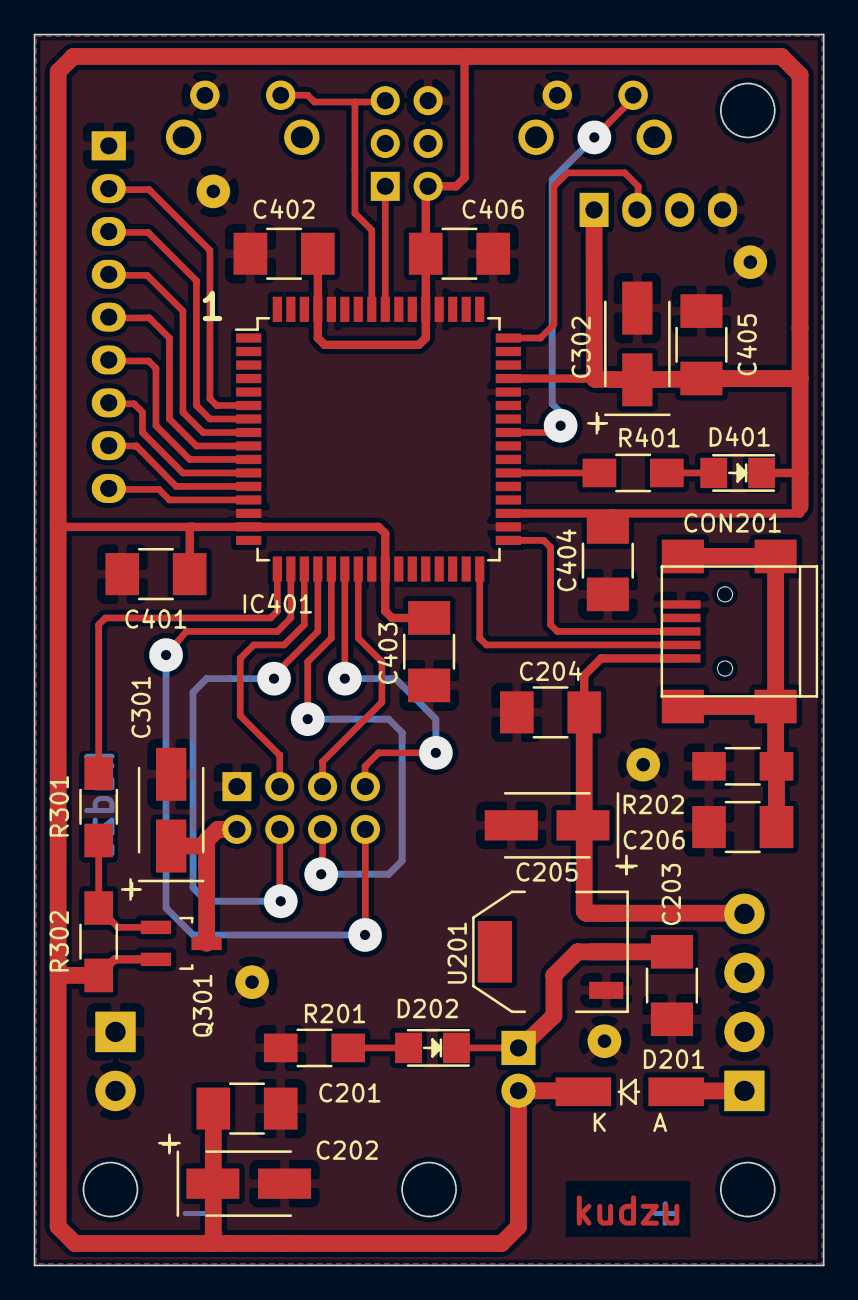
[picture p26: board solar_system_external_unit_board_2.kicad_pcb from above]

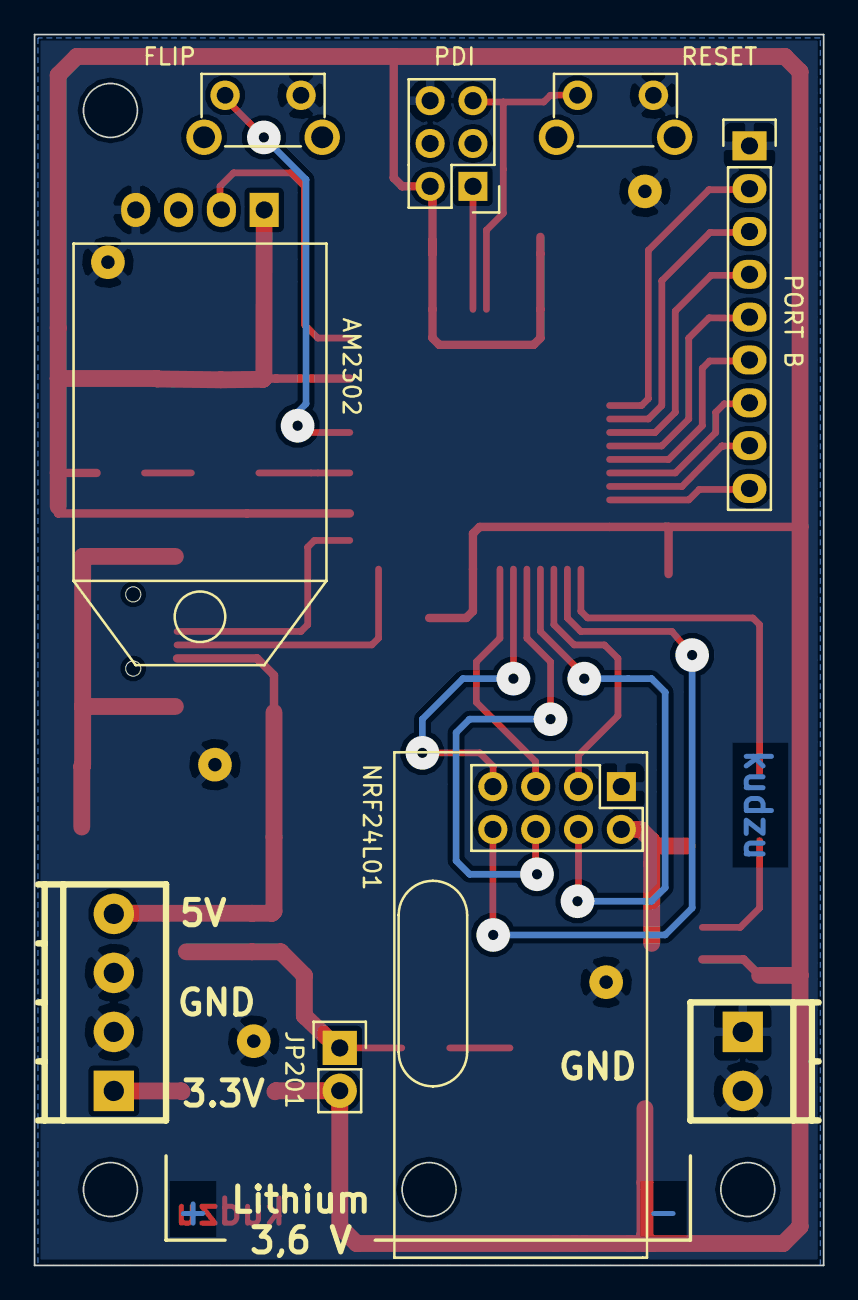
[picture p27: board solar_system_external_unit_board_2.kicad_pcb from below]

Board: 2 copper layers, 46.8 x 73.0 mm, 40 parts (9 on the bottom side), 32 nets.
